JafferSaeed888/Deep-Learning-Based-Image-Processing-for-Autonomous-Pick-and-Place-Systems-/board_mask.png

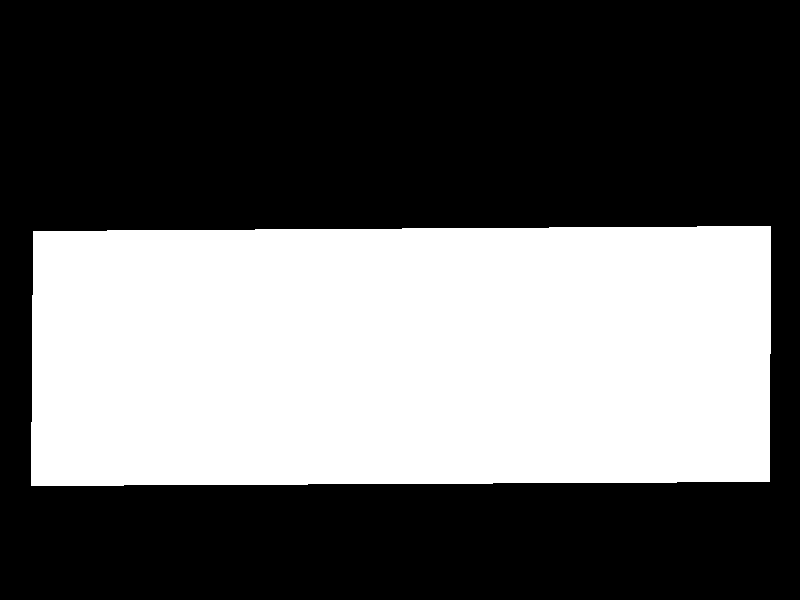
board_mask.png
