JafferSaeed888/Deep-Learning-Based-Image-Processing-for-Autonomous-Pick-and-Place-Systems-/img/Picture4.png

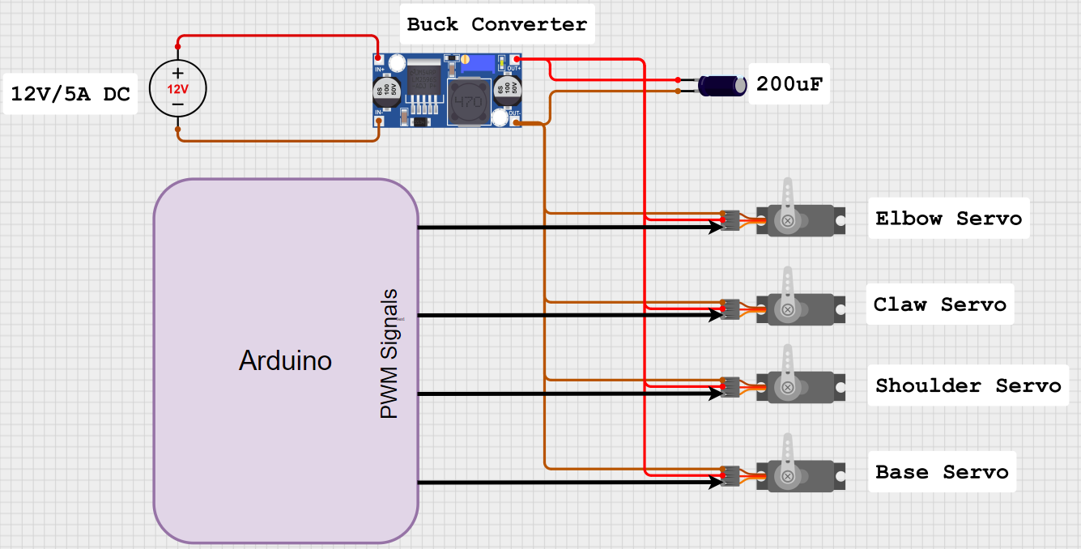
img/Picture4.png
