JafferSaeed888/Deep-Learning-Based-Image-Processing-for-Autonomous-Pick-and-Place-Systems-/calibration_images/20251129145418.jpg

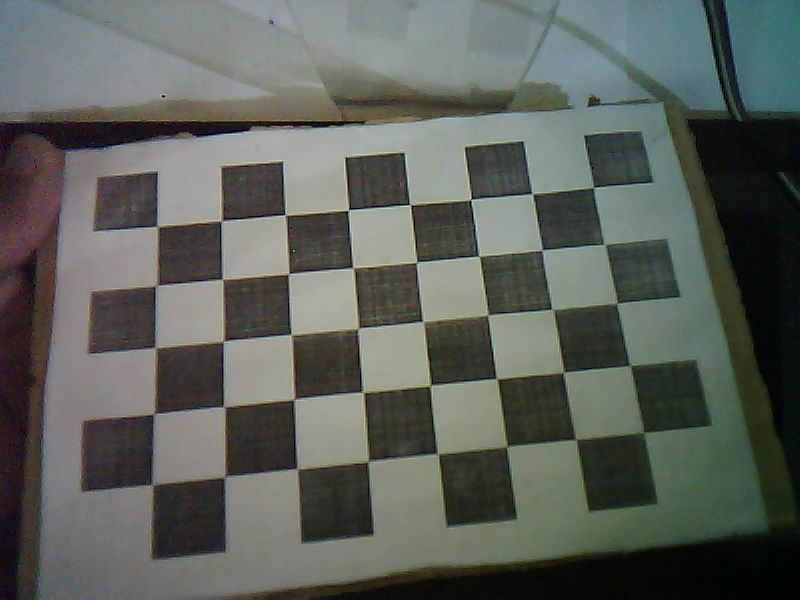
calibration_images/20251129145418.jpg
