JafferSaeed888/Deep-Learning-Based-Image-Processing-for-Autonomous-Pick-and-Place-Systems-/(notices)

Notices in the files:
README.md:
License:
[Python 3.8+](https://www.python.org/downloads/)
[License: MIT](https://opensource.org/licenses/MIT)
License: MIT
